philippHecht98/DyC-RedisCacheLibrelane/docu/src/00_title.md

---
title: "Design eines Redis Cache"
subtitle: |
    Uni-Projekt: Chip Design & Verilog \
    \includegraphics[width=0.5\textwidth]{src/img/hm_logo.png}
author: 
  - "Philipp Hecht"
  - "Luca Pinnekamp"
  - "Luca Schmid"
date: "27. Februar 2026"
lang: "de-DE"
classoption: titlepage
header-includes:
  - \usepackage{graphicx}
  - \usepackage{float}
  - \floatplacement{figure}{H}
  - \pagenumbering{gobble}
abstract: |
  Dieses Dokument beinhaltet unsere Projektdokumenation zur Vorlesung Hardware/Software-Codesign. 
  Das Dokument beschreibt die Implementation und Funktionalität des während des Blockseminars designten Redis-inspirierten Caches.
toc-title: "Inhaltsverzeichnis"
---
