philippHecht98/DyC-RedisCacheLibrelane/docs/ArchitectureDiagram.drawio.png

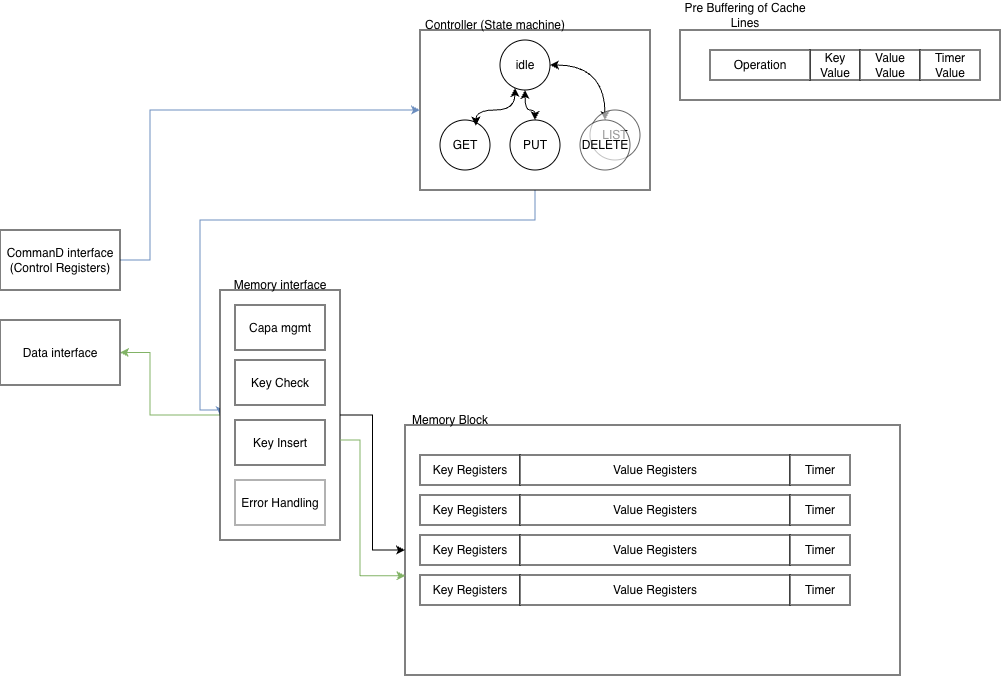
docs/ArchitectureDiagram.drawio.png
