philippHecht98/DyC-RedisCacheLibrelane/docu/src/img/get_zyklus.png

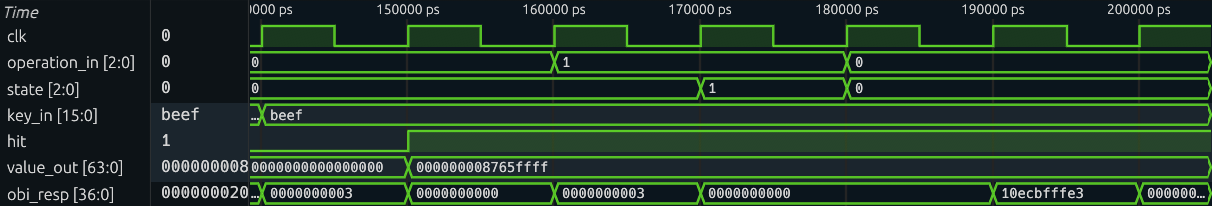
docu/src/img/get_zyklus.png
