philippHecht98/DyC-RedisCacheLibrelane/src/memory/src/memory_dynamic_registerarray.sv

module dynamic_register_array #(
    parameter LENGTH
)(
    input wire clk,
    input wire rst_n,
    input wire write_op,
    input wire [LENGTH-1:0] data_in,
    output wire [LENGTH-1:0] data_out
);

    reg [LENGTH-1:0] registers;

    always_ff @(negedge clk or negedge rst_n) begin
        if (!rst_n) begin
            registers <=  '0;
        end else if (write_op) begin
            registers <= data_in;
        end 
    end

    assign data_out = registers;

endmodule
