philippHecht98/DyC-RedisCacheLibrelane/(commit log)

2026-02-13 Feature/controller (#4)
    * added base memory entry of dynamic lenght
    * updated dynamic block to use negated reset
    * refactored memory_cell module by using registerarray
    * finished intial work on memory block
    * test for memory_dynamic_registerarray
    * created controller
    * Update controller for sub fsm layout per op code
    * Add cmd structure to sub fsm
    ---------
    [controller.sv, ctrl_types_pkg.sv, get_fsm.sv, memory_block.sv, memory_cell.sv, memory_dynamic_registerarray.sv]
2026-02-15 Feature/memory block (#5)
    * moved dynamic registerarray test to test directory
    * updated gitignore
    * updated wire keyword to logic and added write_en logic for writing to a single cell
    * updated memory block logic
    * updated test memory block
    * updated memory data
    * appended test cases for the memory block as a whole
    * updated drawIO
    * fixed bug in test
    * reverted flank behavior from memory block
    * continued working on memory
    ---------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
    [memory_cell.sv]
2026-02-16 Feature/fsm delete (#7)
    * added state diagram for delete fsm
    * updated controller and packages for del state
    * initial implementation of del state machine
    * implemented initial draft of tests of the del fsm
    * updated memory block to reset a cell for the deletion operation
    * updated dynamic register module to interact with the registers on edge and reset
    * reduces states of the del_fsm
    * appended tests
    * pushing current work
    * updated controller and test cases for it
    * updated pkg for del states
    * updated memory registers to recon on deg edge
    * removed select op wire as it is not used
    * updated memory block and updated tests
    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
    [controller.sv, ctrl_types_pkg.sv, del_fsm.sv, memory_block.sv, memory_cell.sv, memory_dynamic_registerarray.sv]
2026-02-18 Feature/interface module (#10)
    * initial setup of interface
    * updated makefile target
    * initial work on axi interface
    * initial implementation of axi interface
    * added croc example
    * current working state for interface
    * continued working on obi interface
    * finished initial implementation of obi interface
    * temp update
    * current state of working with obi
    * removed croc from submodules
    * Add pulp-platform/obi submodule
    * contineud working on the obi interface
    * updated rdata_from_controller reg to rely on negative edge
    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
2026-02-18 Feature/interface module (#12)
    * updated logic of interface
    * updated naming of temp file
    * updated dockerfile for frontend
    * appended tests for obi interface
    * added by_id to dockerignore
    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
2026-02-19 Feature/interface module (#13)
    * updated interface logic to handle read transactions a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
2026-02-19 Fix/interface (#14)
    * initial commit
    * added drawIO image
    * updated submodule; started working on pipeline testing with docker file
    * added event for local pipeline testing
    * updated build pipeline for docker build
    * updated docker file
    * added docker ignore
    * added architecture diagram in png format
    * Update pipeline configuration
    * Update tests readme to work for pytest pipeline setup
    * Update test location
    * Update global makefile for full and individual builds
    * Add chip example for later adjustment
    * Feature/controller (#4)
    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
    [controller.sv, ctrl_types_pkg.sv, del_fsm.sv, get_fsm.sv, if_types_pkg.sv, memory_block.sv, memory_cell.sv]
2026-02-19 Revert "Fix/interface (#14)" (#15)
    This reverts commit a7c5fd9a726f92111adbb3744e43b4dc4d7e18b3.
    [controller.sv, ctrl_types_pkg.sv, del_fsm.sv, get_fsm.sv, if_types_pkg.sv, memory_block.sv, memory_cell.sv]
2026-02-19 fixed address calculation of obi interface (#16)
    [obi_interface.sv]
2026-02-19 Fix/interface (#17)
    * fixed address calculation of obi interface
    * updated obi interface logic
    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
    [obi_interface.sv]
2026-02-19 Add hit status and fix combinatorial loops
    [controller.sv, del_fsm.sv, get_fsm.sv, if_types_pkg.sv, memory_block.sv, obi_interface.sv, upsert_fsm.sv]
2026-02-20 Cleanup and fix pipelines (#20)
    * Update packages for unified config
    * Fix frontend pipeline
    * Fix backend pipeline
    * Remove not needed submodules
    [controller.sv, del_fsm.sv, if_types_pkg.sv, memory_block.sv, obi_interface.sv]
2026-02-27 Docu/init (#33)
    * docu init using pandoc
    * inculded drawio setup for the docu
    * temp
    * updated docu
    * inital todos marked in doc
    * updated docu
    * Docu/luca s (#24)
    * updated docu
    * Docu/philipp (#25)
    * added initial draft of the memory implementation
    * current working stand
    * continued working on documentation
    * Updated docu (#26)
    * Add initial version of Luca P docu parts (#28)
    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
